jero98772/Ktopo/drawings/drill_mechanism.png

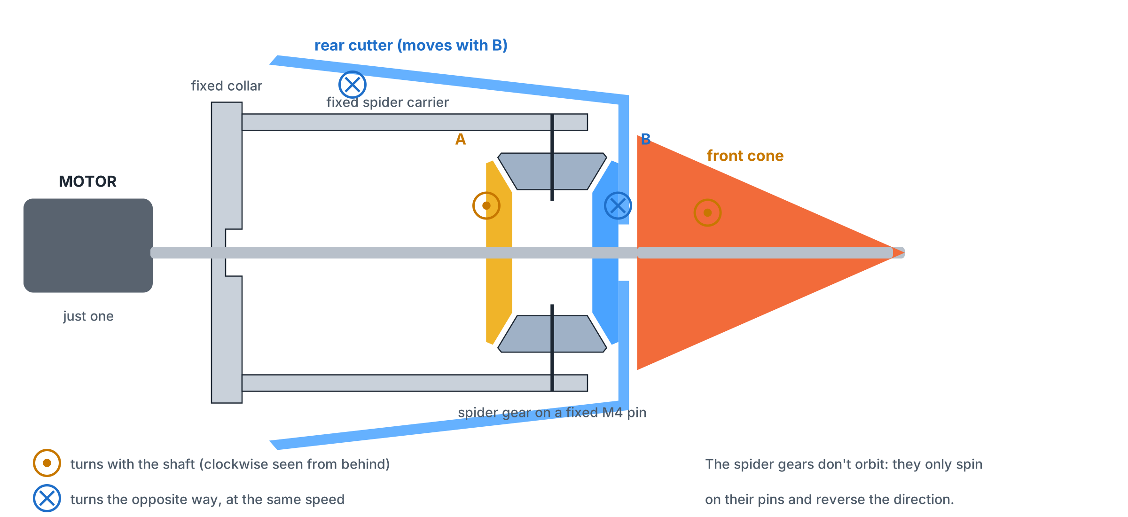
drawings/drill_mechanism.png
