jero98772/Ktopo/drawings/render_drill_section.png

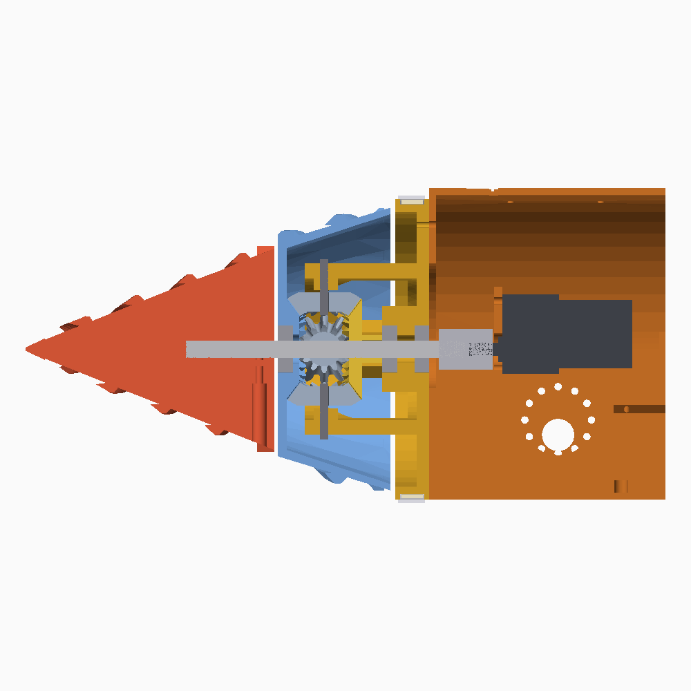
drawings/render_drill_section.png
