jero98772/Ktopo/drawings/render_iso.png

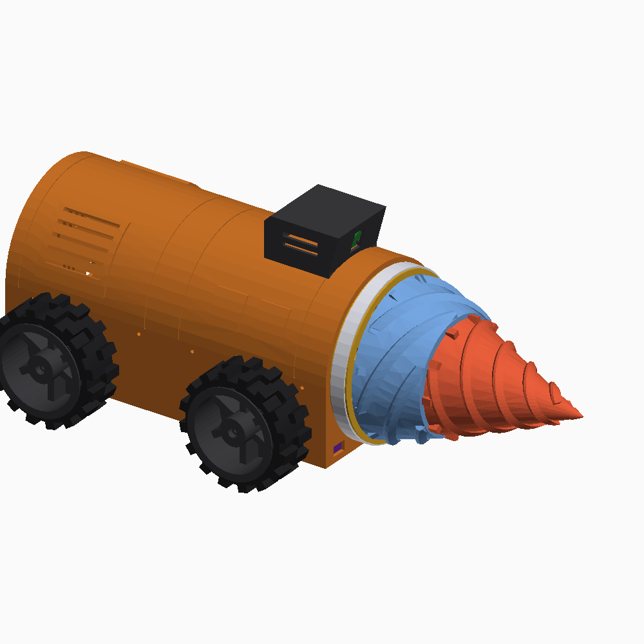
drawings/render_iso.png
