jero98772/Ktopo/drawings/render_no_hull.png

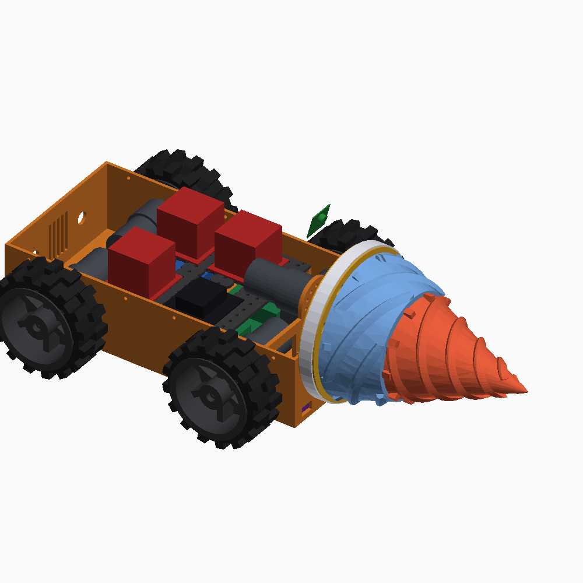
drawings/render_no_hull.png
