jero98772/Ktopo/drawings/render_side.png

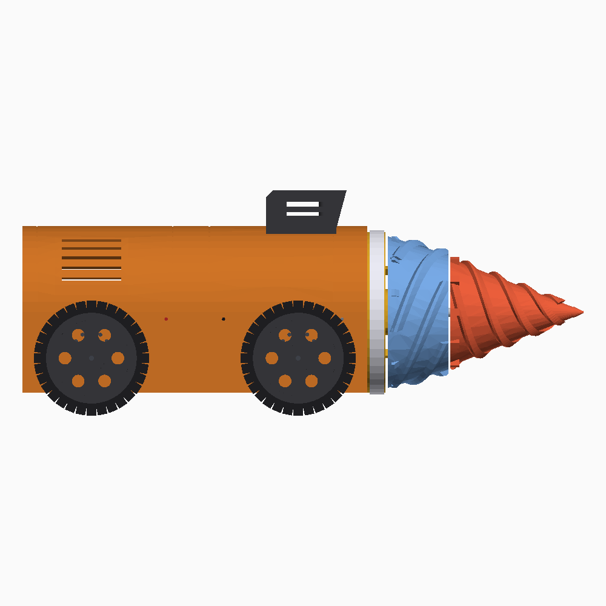
drawings/render_side.png
