jero98772/Ktopo/drawings/software_architecture.png

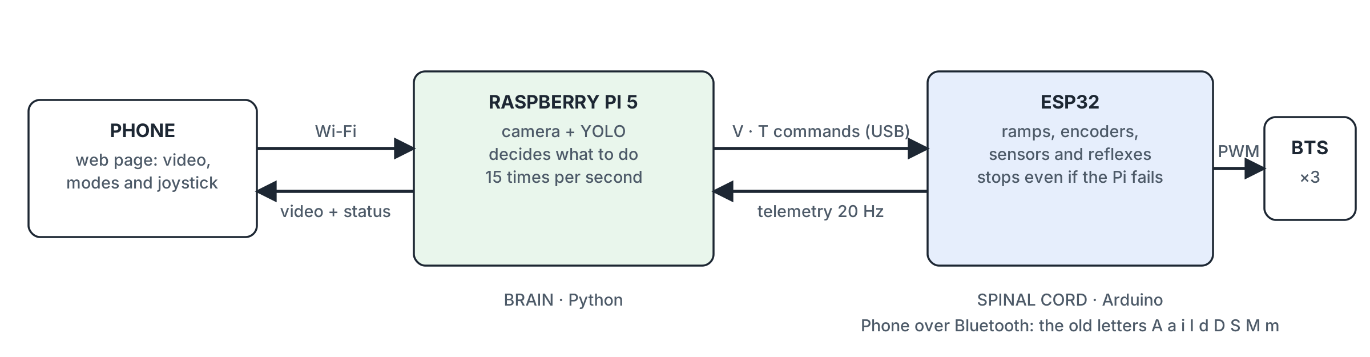
drawings/software_architecture.png
