jero98772/Ktopo/cad/step/Ktopo_assembly.step

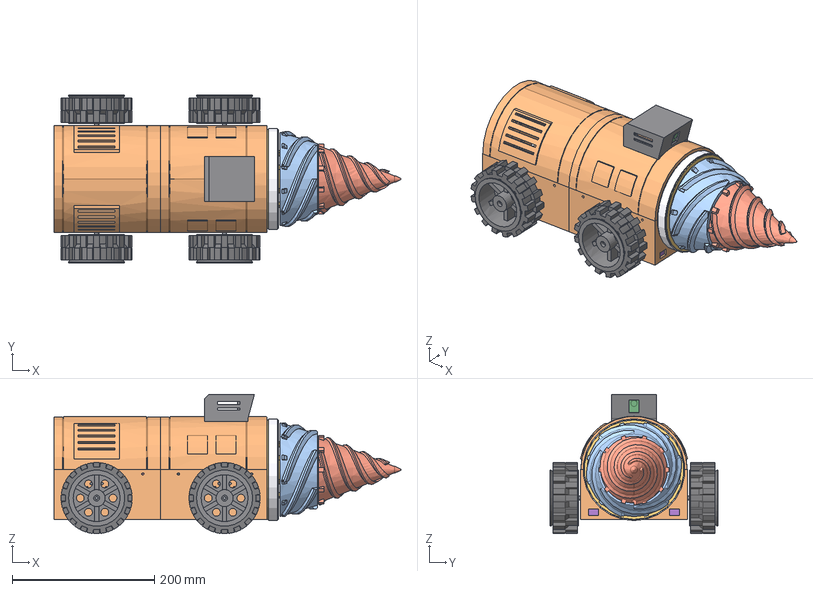
[picture p7: CAD file, 2026-10-19]
cad/step/Ktopo_assembly.step
488.2 x 236.0 x 196.0 mm
chassis_front
chassis_rear
electronics_deck
collar_carrier
gear_A
spider_gear_1
spider_gear_2
spider_gear_3
spider_gear_4
rear_cutter
front_cone
shaft_spacer
led_diffuser
hull_front
hull_rear
cab
wheel_rim_1
wheel_rim_2
wheel_rim_3
wheel_rim_4
wheel_tire_TPU_1
wheel_tire_TPU_2
wheel_tire_TPU_3
wheel_tire_TPU_4
drive_motor_1
drive_motor_2
drive_motor_3
drive_motor_4
drill_motor
shaft_8mm
coupler_6to8
bearing_608_1
bearing_608_2
bearing_608_3
pin_M4_1
pin_M4_2
pin_M4_3
pin_M4_4
raspberry_pi5
battery_3S2P
buck_5V5A_pi
buck_5V3A
bts7960_left
bts7960_right
bts7960_drill
esp32_terminal_board
camera_pi3
vl53l0x_1
vl53l0x_2
mpu6050
ws2812_strip
