jero98772/Ktopo/cad/step/electronics_deck.step

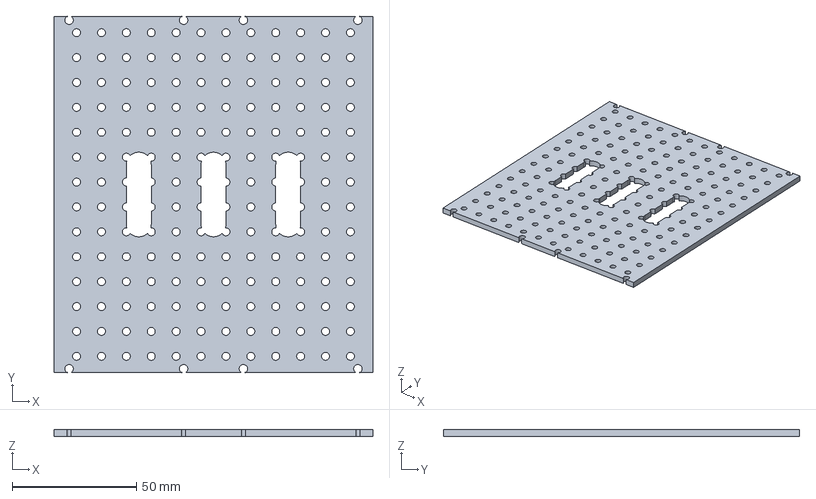
[picture p8: CAD file, 2026-10-19]
cad/step/electronics_deck.step
128.0 x 143.0 x 3.00 mm
