jero98772/Ktopo/cad/step/chassis_rear.step

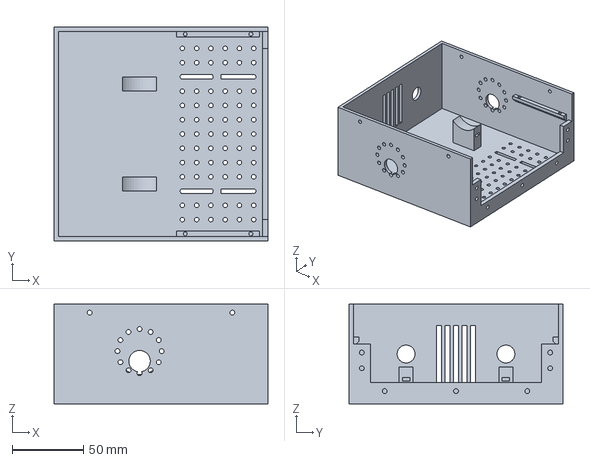
[picture p9: CAD file, 2026-10-19]
cad/step/chassis_rear.step
150.0 x 150.0 x 70.0 mm
