jero98772/Ktopo/cad/step/rear_cutter.step

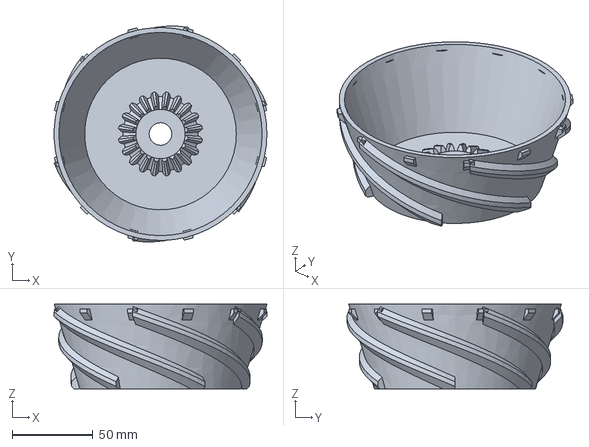
[picture p10: CAD file, 2026-10-19]
cad/step/rear_cutter.step
132.1 x 133.7 x 52.6 mm
