jero98772/Ktopo/cad/step/led_diffuser.step

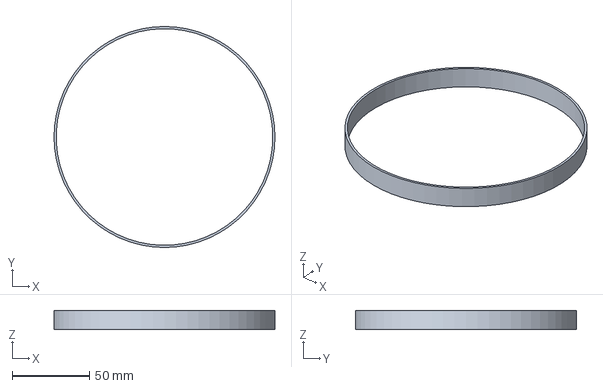
[picture p11: CAD file, 2026-10-19]
cad/step/led_diffuser.step
143.2 x 143.2 x 12.5 mm
