jero98772/Ktopo/cad/step/spider_gear.step

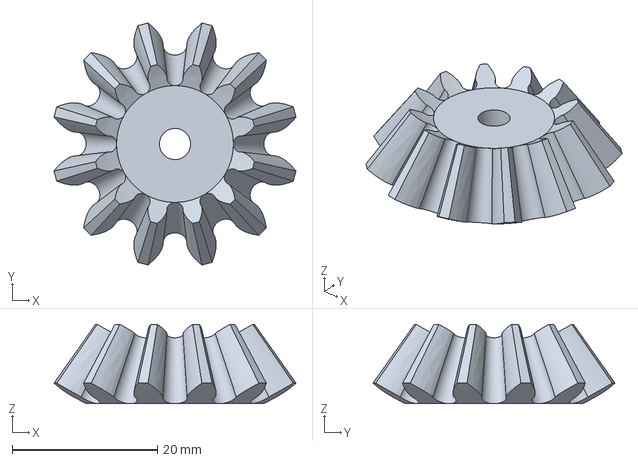
[picture p12: CAD file, 2026-10-19]
cad/step/spider_gear.step
33.3 x 33.3 x 10.9 mm
