jero98772/Ktopo/cad/step/chassis_front.step

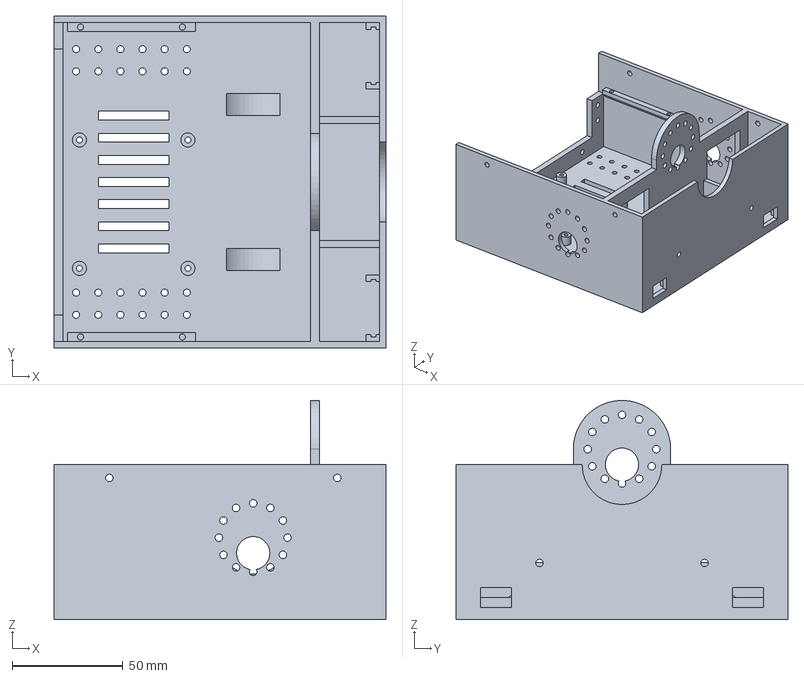
[picture p13: CAD file, 2026-10-19]
cad/step/chassis_front.step
150.0 x 150.0 x 99.0 mm
