jero98772/Ktopo/cad/step/collar_carrier.step

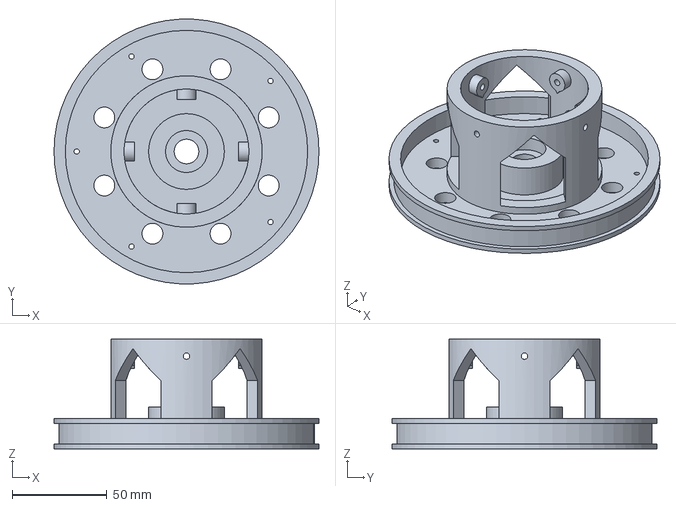
[picture p14: CAD file, 2026-10-19]
cad/step/collar_carrier.step
140.0 x 139.8 x 58.0 mm
