jero98772/Ktopo/cad/step/wheel_tire_TPU.step

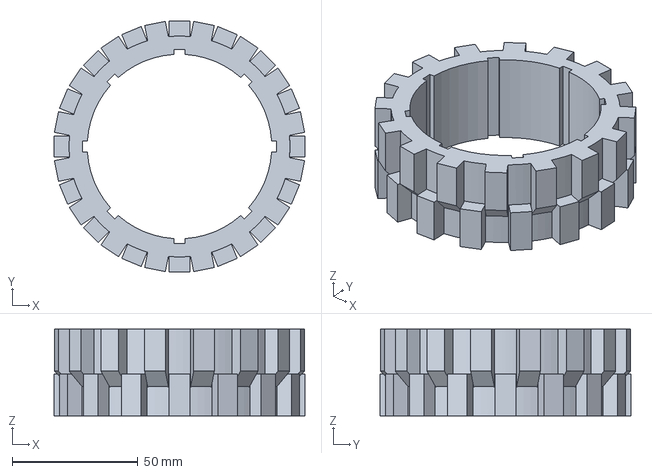
[picture p15: CAD file, 2026-10-19]
cad/step/wheel_tire_TPU.step
100.0 x 100.0 x 34.5 mm
