jero98772/Ktopo/cad/step/hull_rear.step

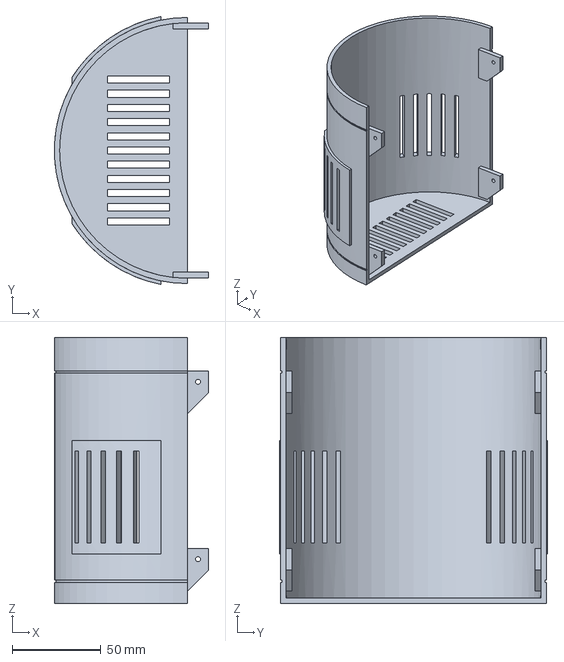
[picture p16: CAD file, 2026-10-19]
cad/step/hull_rear.step
87.0 x 151.0 x 150.0 mm
