jero98772/Ktopo/cad/step/wheel_rim.step

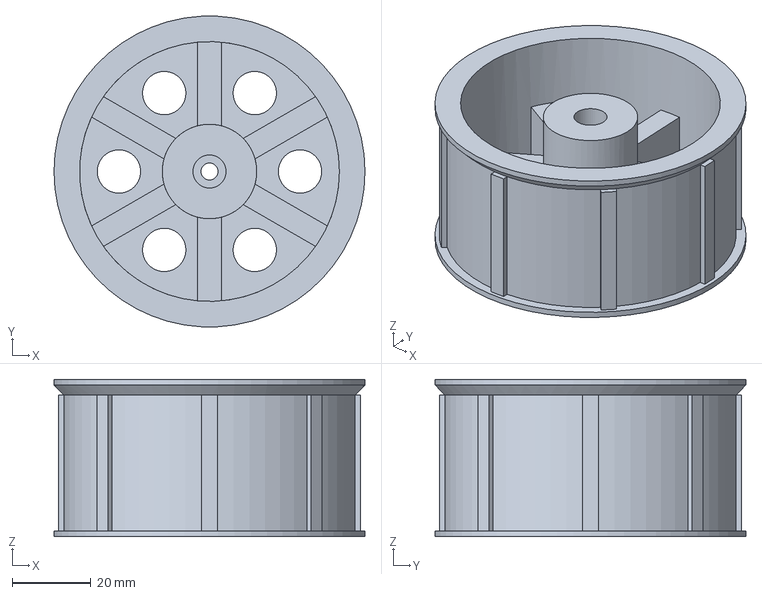
[picture p17: CAD file, 2026-10-19]
cad/step/wheel_rim.step
79.0 x 78.9 x 40.0 mm
