jero98772/Ktopo/cad/step/front_cone.step

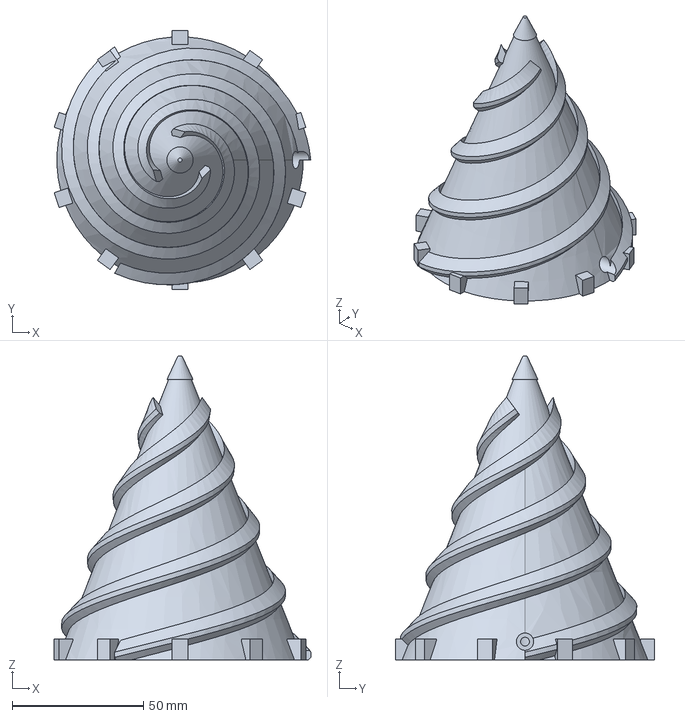
[picture p18: CAD file, 2026-10-19]
cad/step/front_cone.step
97.9 x 99.0 x 116.0 mm
