jero98772/Ktopo/cad/step/cab.step

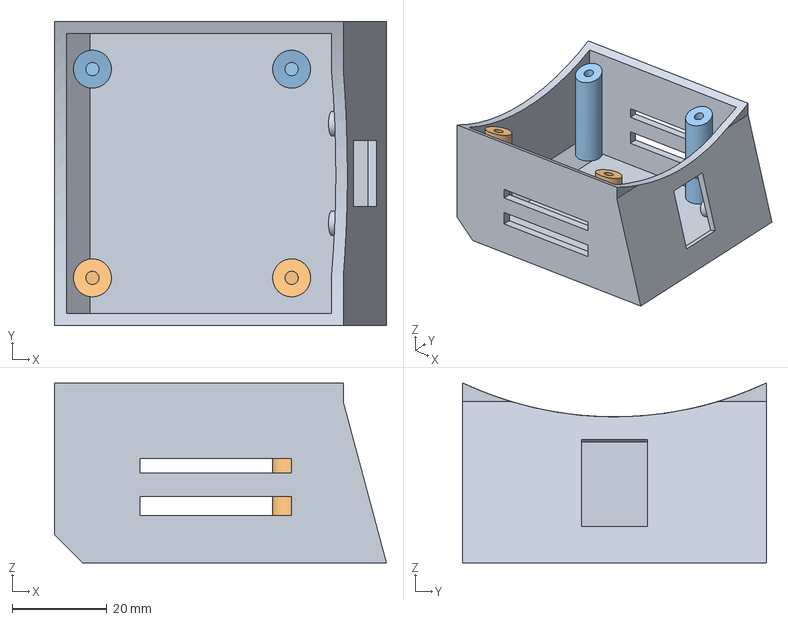
[picture p19: CAD file, 2026-10-19]
cad/step/cab.step
70.0 x 64.0 x 37.9 mm
