jero98772/Ktopo/cad/step/hull_front.step

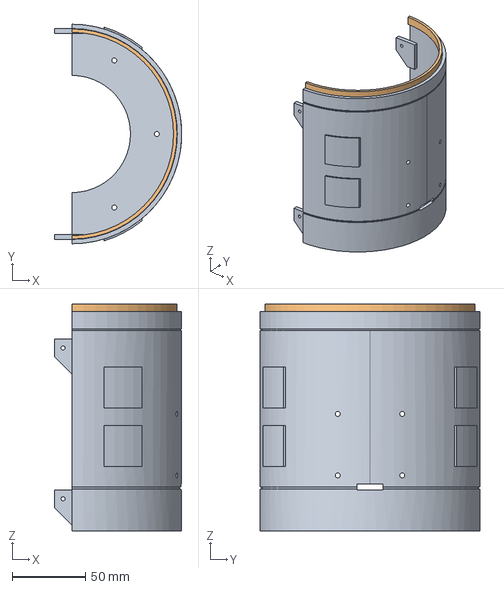
[picture p20: CAD file, 2026-10-19]
cad/step/hull_front.step
87.0 x 150.0 x 155.0 mm
