jero98772/Ktopo/cad/step/shaft_spacer.step

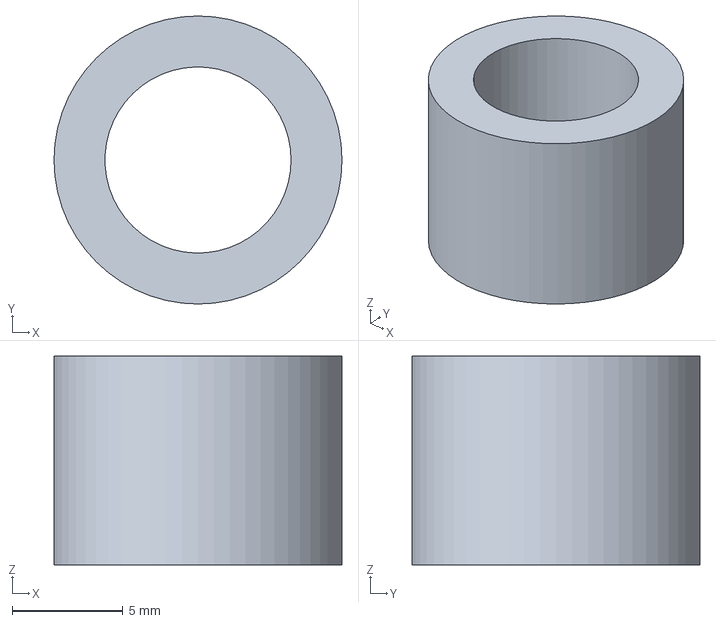
[picture p21: CAD file, 2026-10-19]
cad/step/shaft_spacer.step
13.0 x 13.0 x 9.42 mm
