jero98772/Ktopo/cad/step/gear_A.step

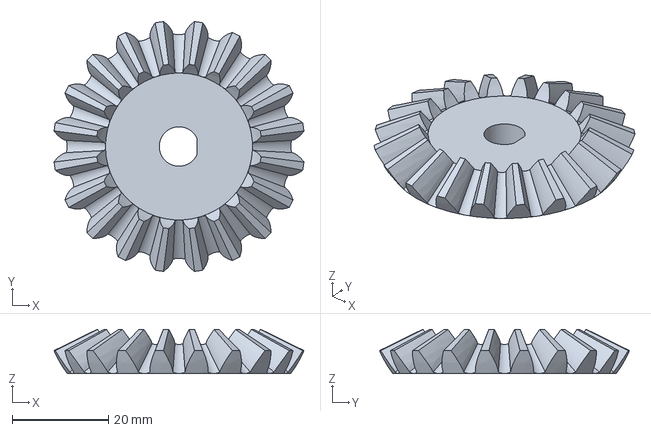
[picture p22: CAD file, 2026-10-19]
cad/step/gear_A.step
52.0 x 52.0 x 9.16 mm
