jero98772/Ktopo/(list of files, cad)

Other CAD files:
cad/stl/cab.stl
cad/stl/chassis_front.stl
cad/stl/chassis_rear.stl
cad/stl/collar_carrier.stl
cad/stl/electronics_deck.stl
cad/stl/front_cone.stl
cad/stl/gear_A.stl
cad/stl/hull_front.stl
cad/stl/hull_rear.stl
cad/stl/led_diffuser.stl
cad/stl/rear_cutter.stl
cad/stl/shaft_spacer.stl
cad/stl/spider_gear.stl
cad/stl/wheel_rim.stl
cad/stl/wheel_tire_TPU.stl
