jero98772/Ktopo/drawings/wiring_diagram.png

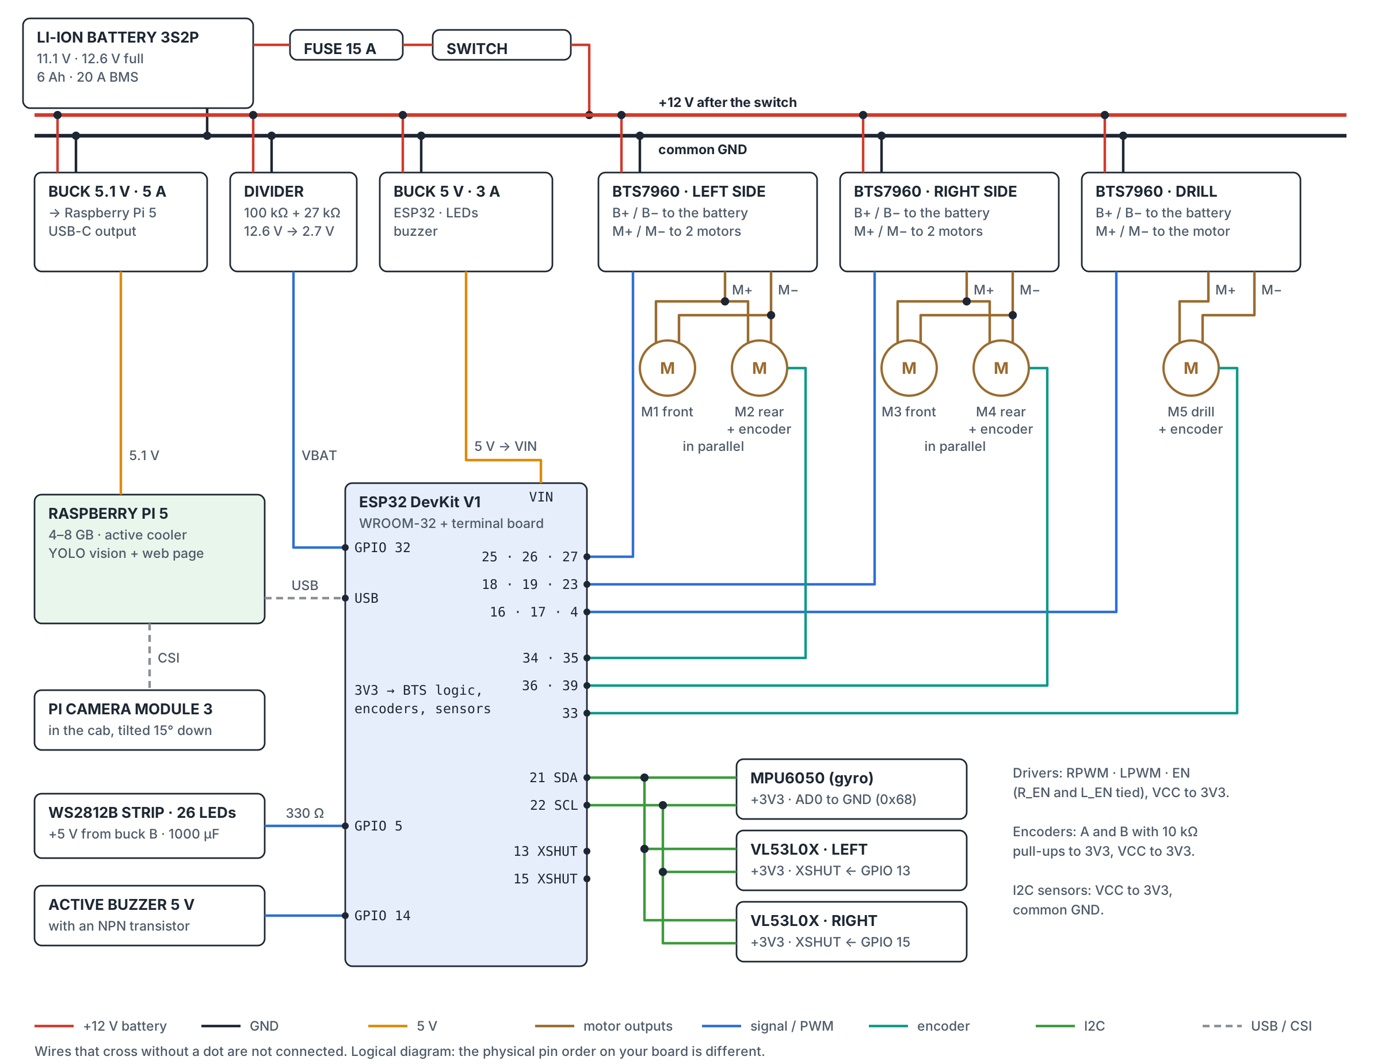
drawings/wiring_diagram.png
