jero98772/Ktopo/(commit log)

2026-10-19 add content spanish
    [TOPO_S14_ensamble.step, bandeja_electronica.step, bandeja_electronica.stl, cabina.step, cabina.stl, casco_delantero.step, casco_delantero.stl, casco_trasero.step]
2026-10-19 switch to english
    [Ktopo_assembly.step, TOPO_S14_ensamble.step, bandeja_electronica.step, cab.step, cab.stl, cabina.step, casco_delantero.step, casco_trasero.step]
